Dulan24/Apnemeter/PCB/Project Outputs for PCB_Project/Status Report(1).Txt

Output: NC Drill Files
Type  : NC Drill
From  : Project [PCB_Project.PrjPcb]
   Generated File[PCB1.TXT]
   Generated File[PCB1.LDP]
   Generated File[PCB1.DRR]

Files Generated   : 3
Documents Printed : 0

Finished Output Generation At 9:41:43 PM On 30-Sep-22
