Dulan24/Apnemeter/mobile application/screenshots of app.docx

Android app

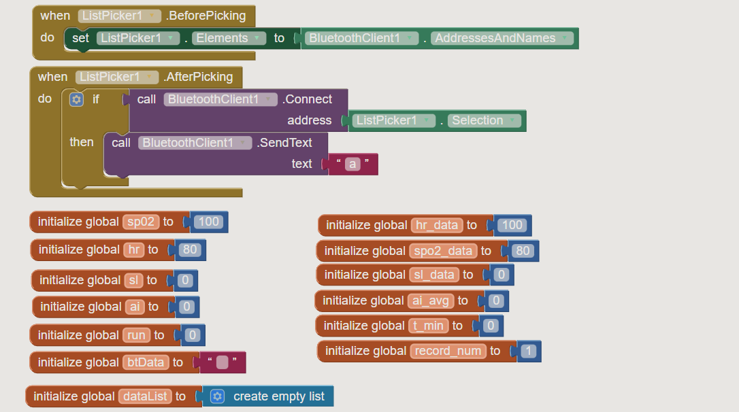
[picture p1: figure]
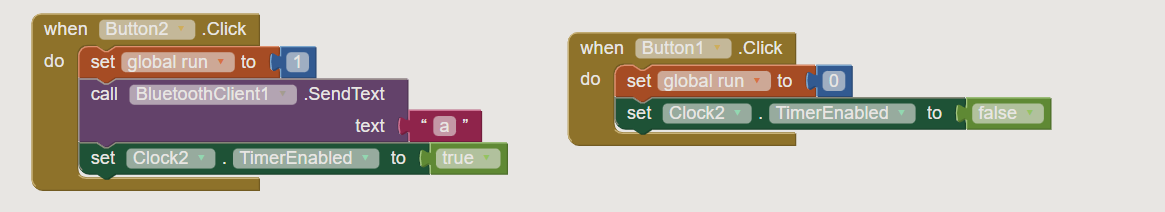
[picture p2: figure]
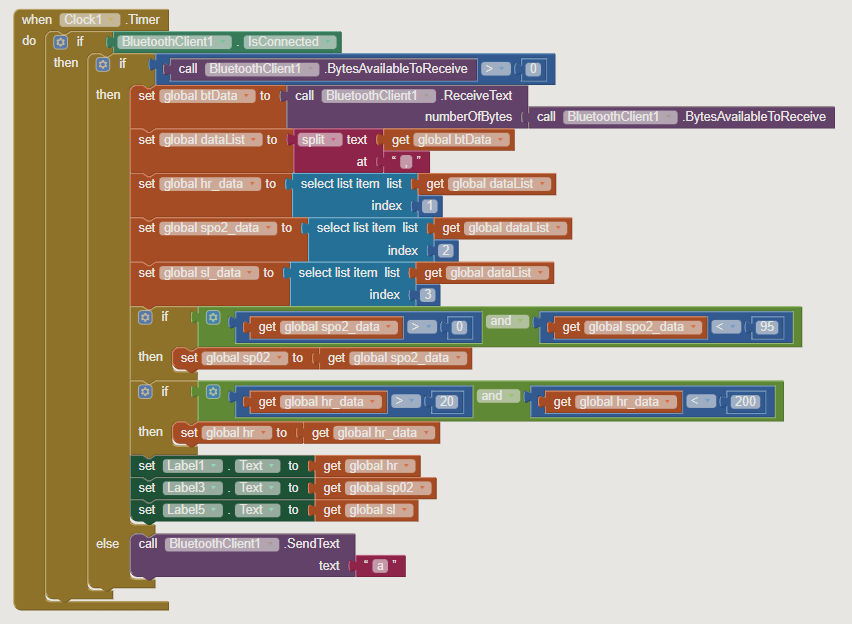
[picture p3: figure]
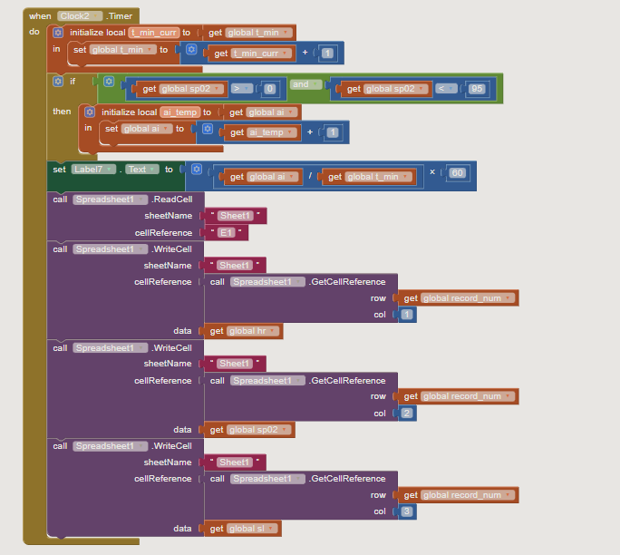
[picture p4: figure]

Arduino Code

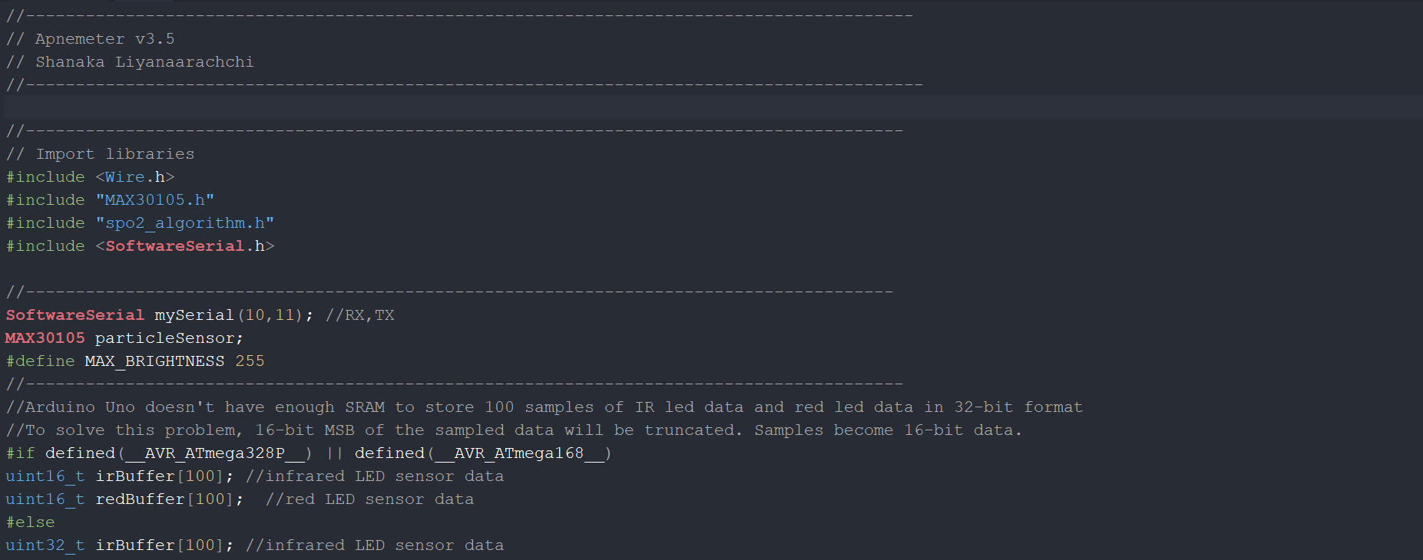
[picture p5: figure]
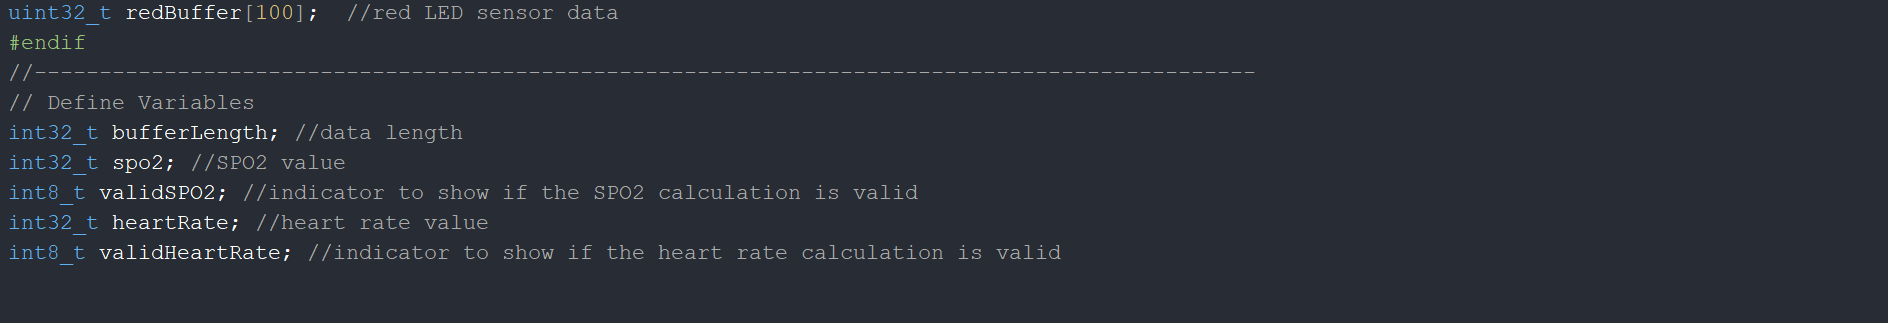
[picture p6: figure]
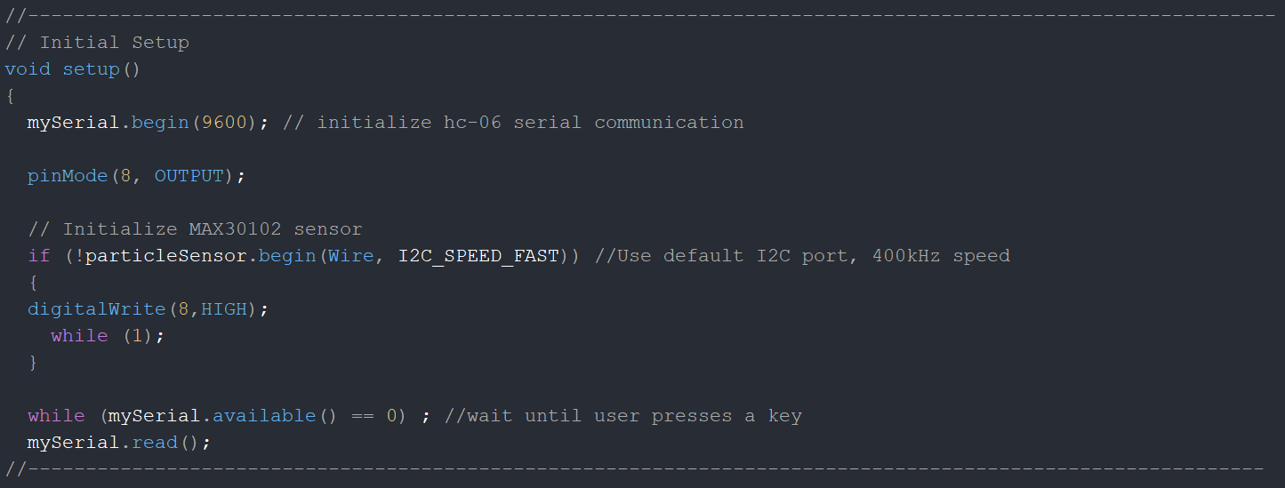
[picture p7: figure]
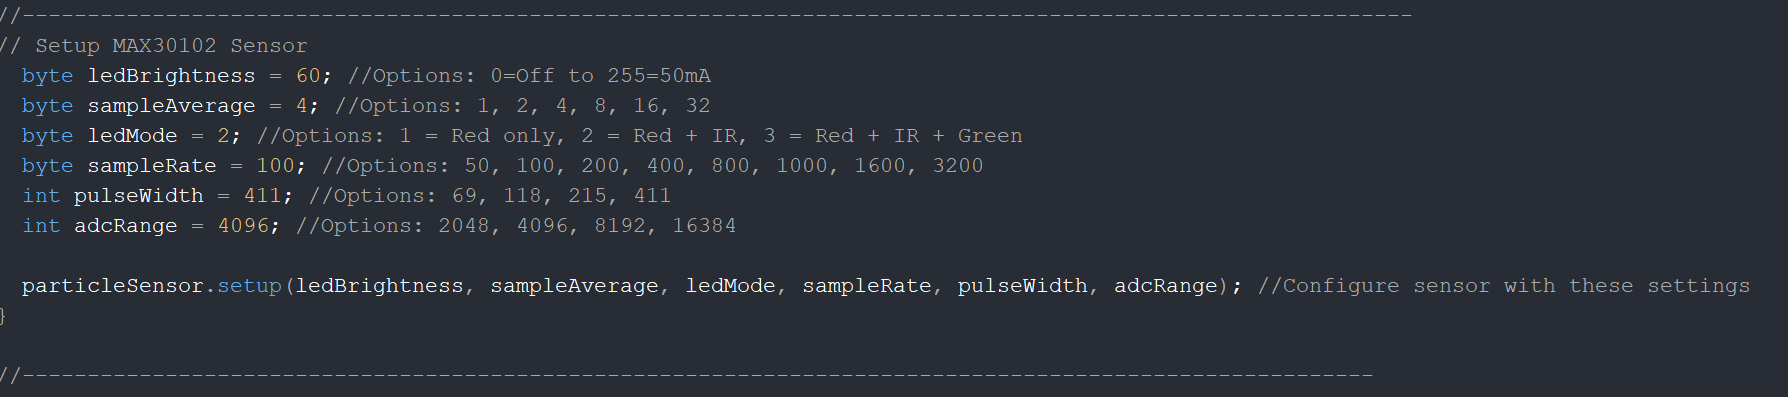
[picture p8: figure]
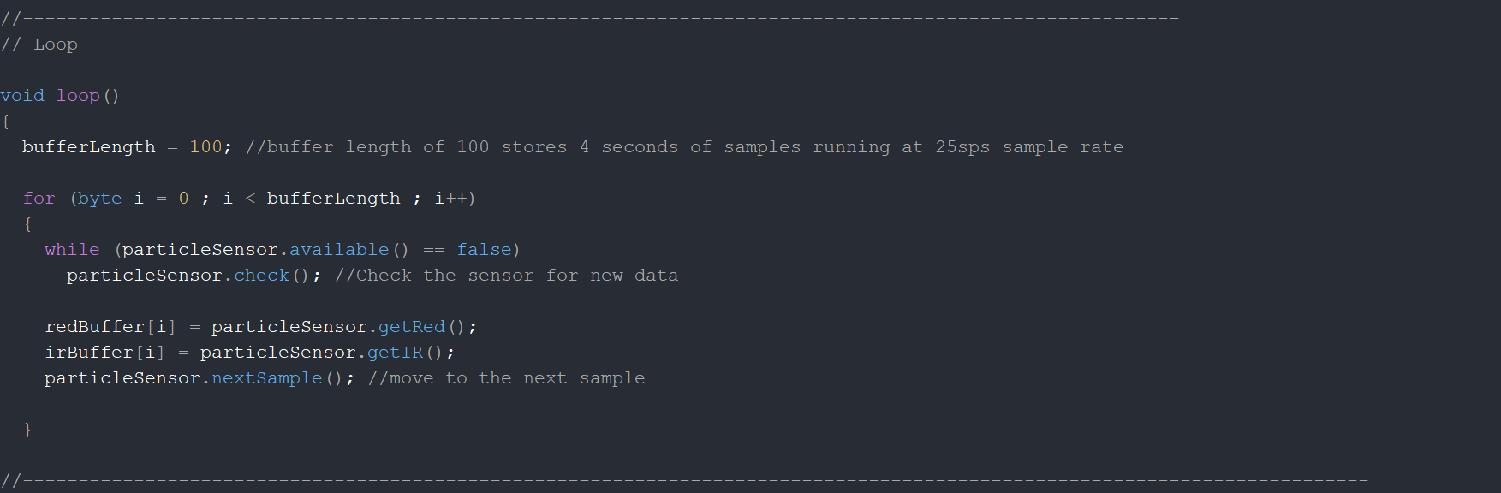
[picture p9: figure]
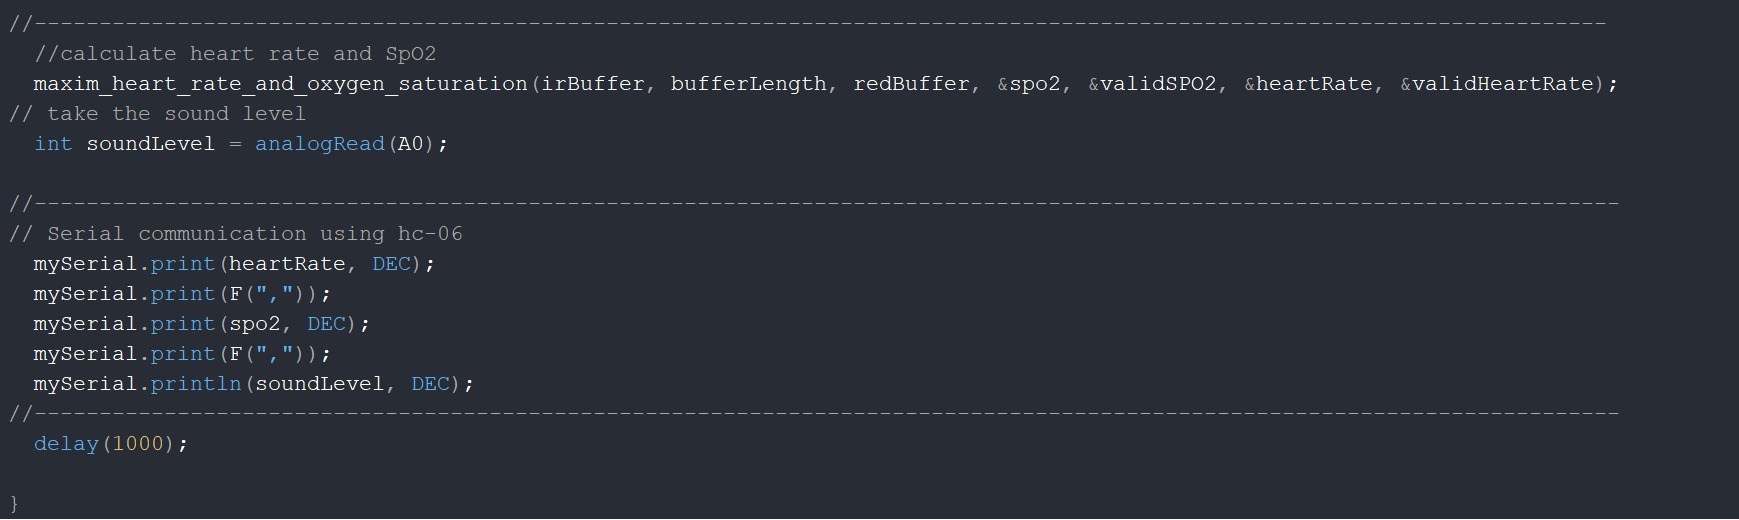
[picture p10: figure]

Google Cloud

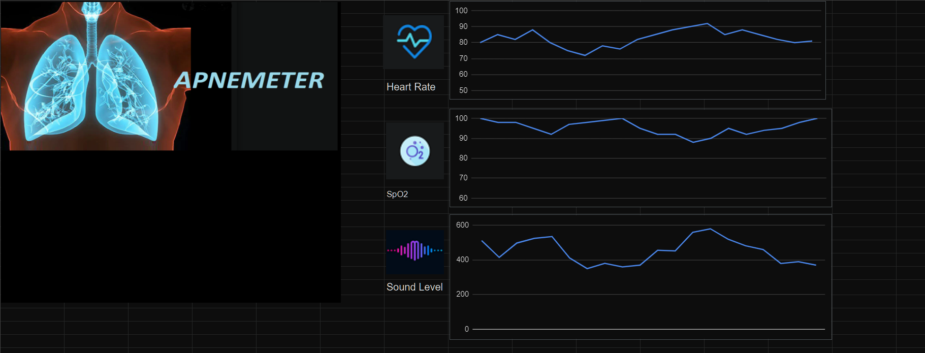
[picture p11: figure]
