Dulan24/Apnemeter/Solidworks design files/Assem2.SLDASM

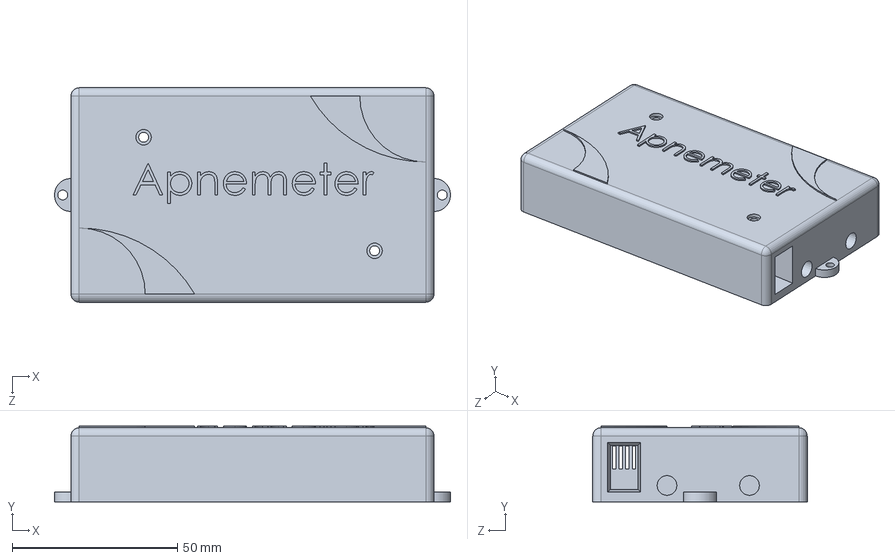
[picture p48: CAD file, 2023-03-15]
Solidworks design files/Assem2.SLDASM
120.0 x 23.0 x 65.0 mm
