Dulan24/Apnemeter/Solidworks design files/lowernew (1).SLDPRT

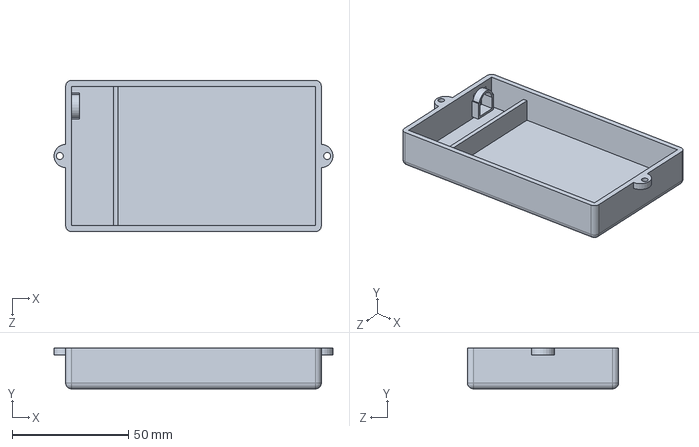
[picture p49: CAD file, 2023-03-15]
Solidworks design files/lowernew (1).SLDPRT
120.0 x 17.5 x 65.0 mm
