Dulan24/Apnemeter/Solidworks design files/new_finger (2).SLDPRT

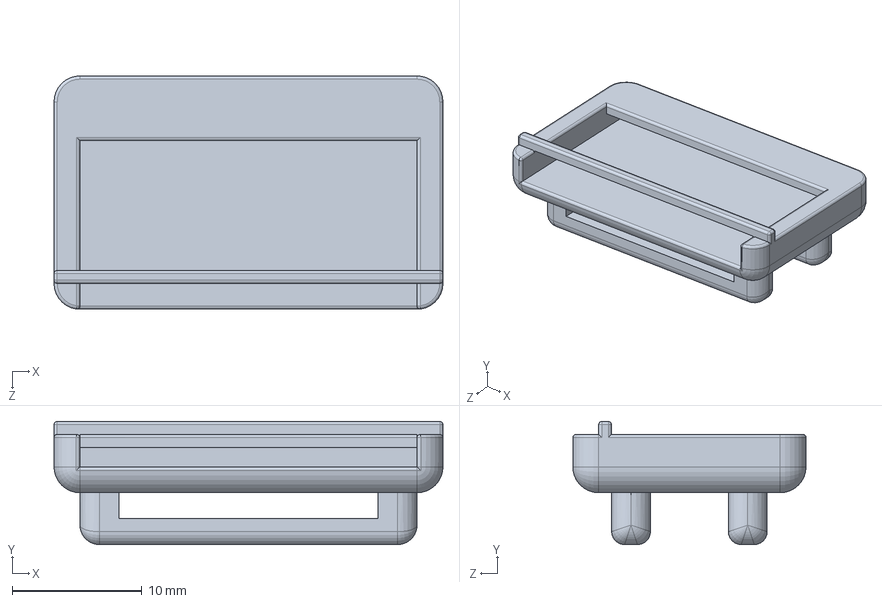
[picture p50: CAD file, 2023-03-15]
Solidworks design files/new_finger (2).SLDPRT
30.0 x 9.50 x 18.0 mm
