Dulan24/Apnemeter/(list of files, cad)

Other CAD files:
Solidworks design files/upper new (1).SLDPRT
