Dulan24/Apnemeter/(list of files, drawings)

Other design files:
PCB/dulan.PrjPcb
PCB/PCB1(1).PcbDoc
PCB/schematic1(1).SchDoc
